Voldemar-d/Arduino-AY-player/Arduino-AY-player-circuit.png

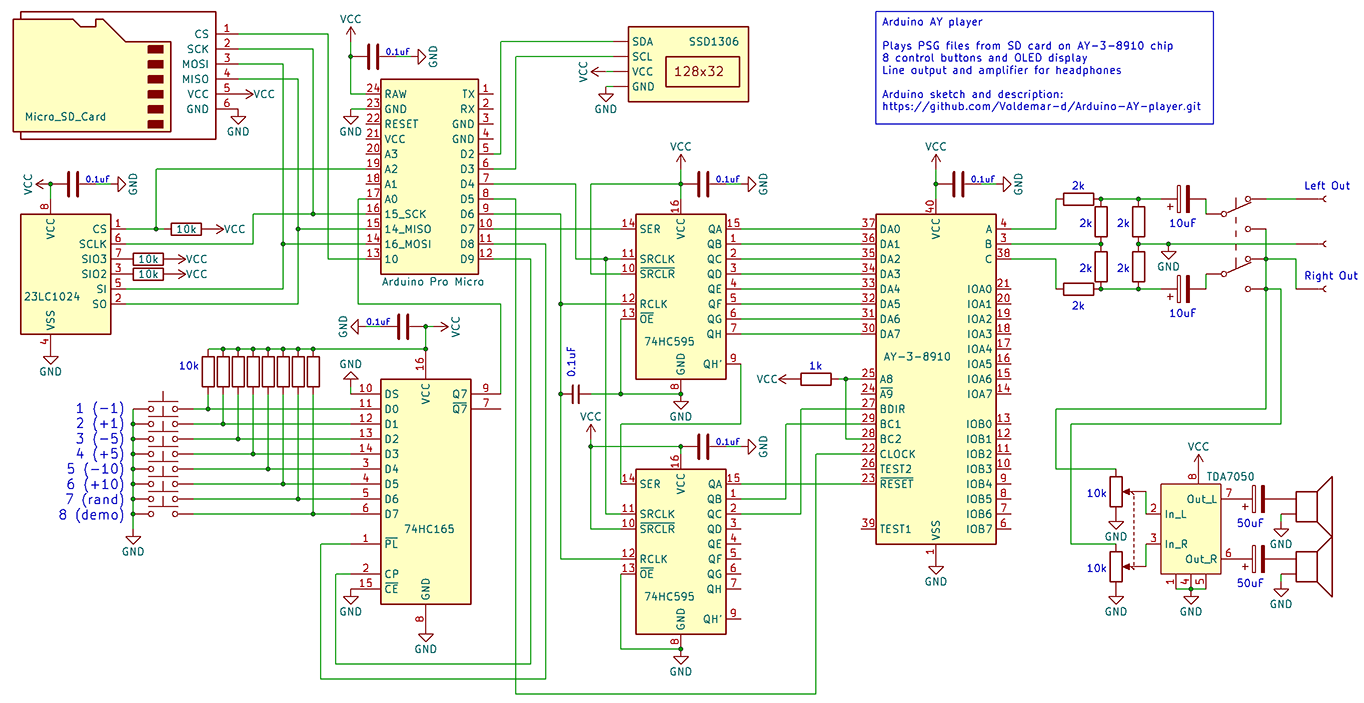
Arduino-AY-player-circuit.png
