Voldemar-d/Arduino-AY-player/Arduino-AY-player-circuit.pdf

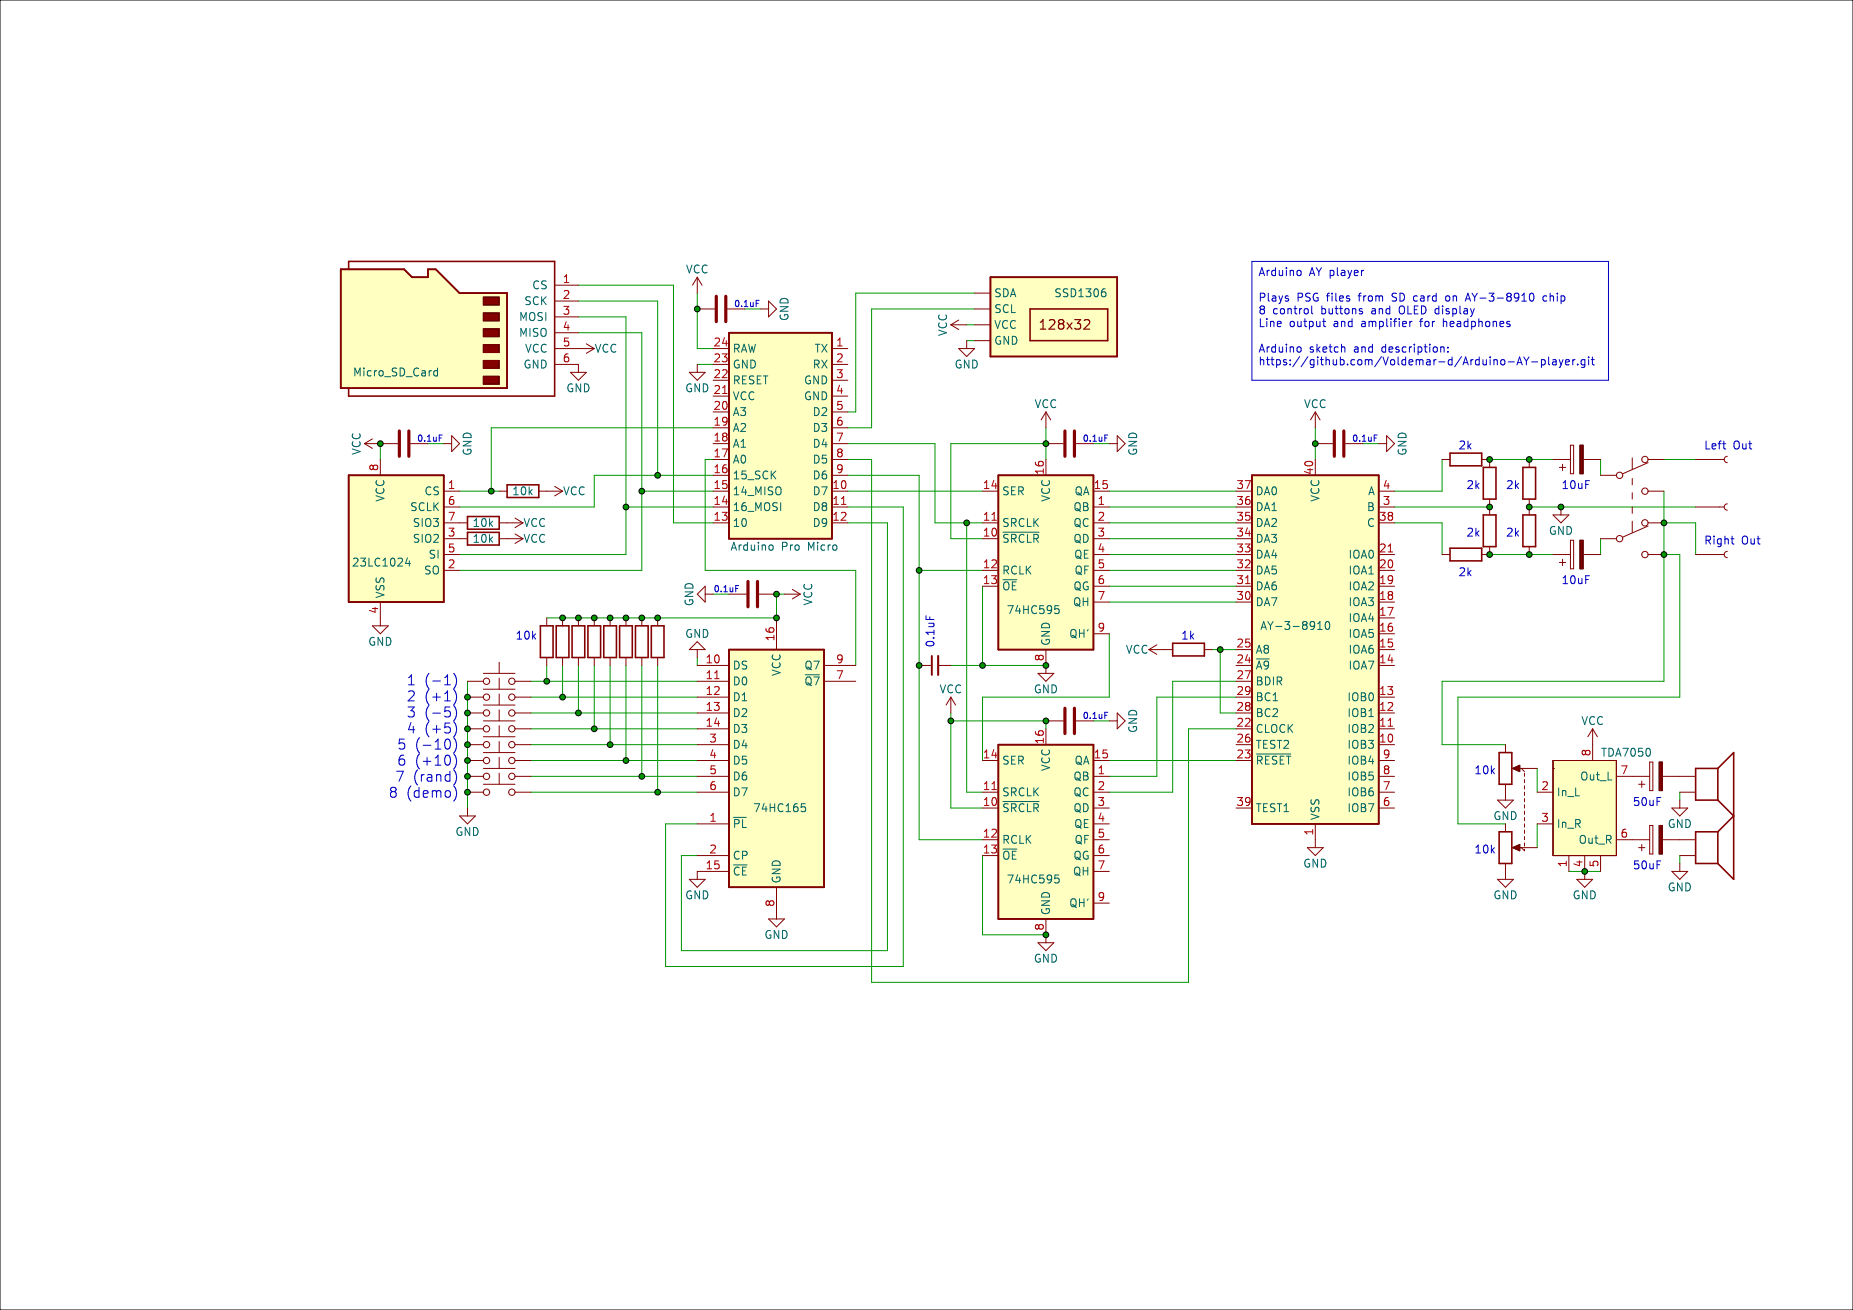
[picture p3: page 1]
