Voldemar-d/Arduino-AY-player/(commit log)

2023-06-19 Added circuit
2023-06-22 Added board photo
2024-02-03 Updated circuit and README.md
2024-02-05 Updated circuit
2024-02-21 Updated button processing
